mlashley/cvduino/README.md

# CVduino

Documenting my attempt to make a general purpose MIDI/CV/Arduino-like board.
