mlashley/cvduino/hardware/pwm_cv_multisim_weblink.txt

https://www.multisim.com/content/9pv5kF2uwTvokZKrmRoAAM/pwm-to-cv/open/
