mlashley/cvduino/misc/links.txt

https://web.archive.org/web/20190512002632/https://www.stereoping.com/eurorack-diy-offset-scaler/?lang=en
http://www.bartonmusicalcircuits.com/atnmix/documentation.pdf
http://www.modular.fonik.de/pdf/RetroAtt.pdf
http://www.varal.org/ttymidi/
