mlashley/cvduino/hardware/PCB.png

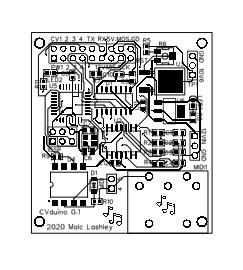
hardware/PCB.png
