mlashley/cvduino/hardware/Schematic.png

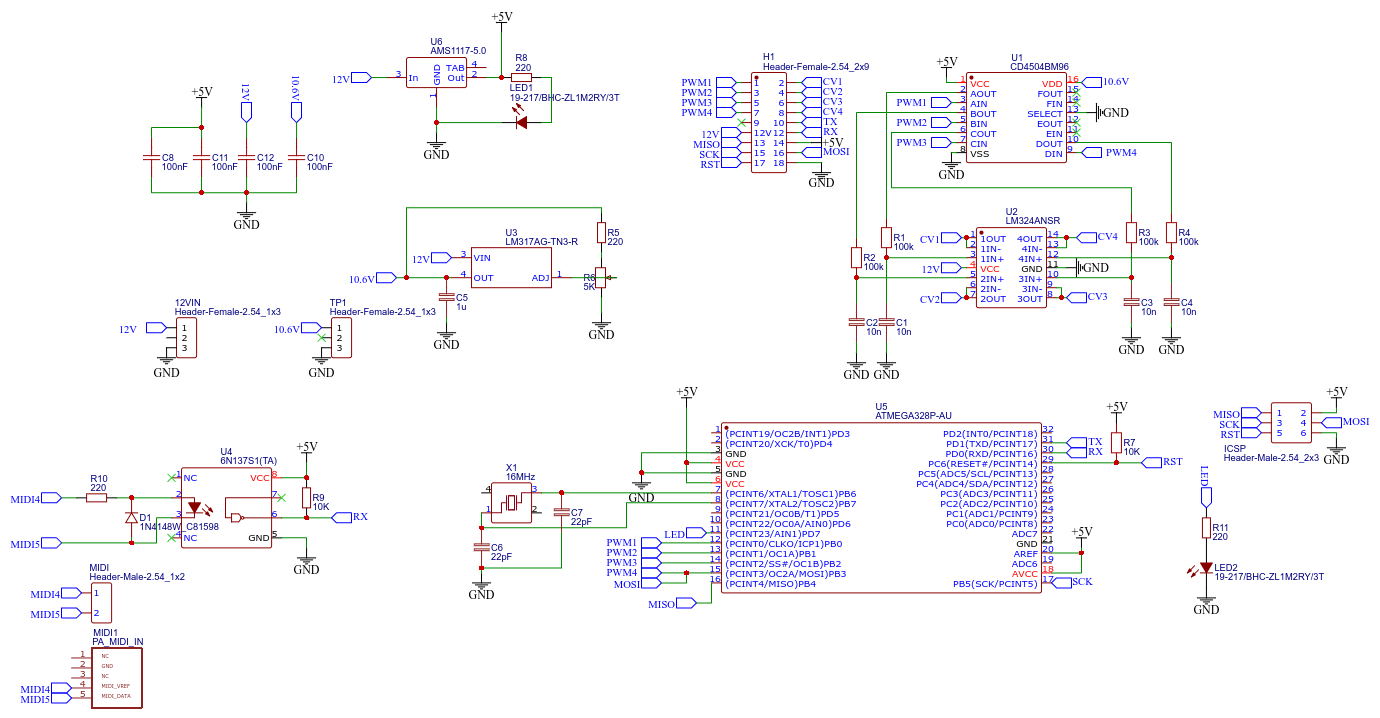
hardware/Schematic.png
