mlashley/cvduino/(list of files, drawings)

Other design files:
hardware/EasyEDA_PCB.json
hardware/EasyEDA_Schematic.json
