mlashley/cvduino/(commit log)

2020-12-24 Initial commit (HW designs as manufatured)
    [PCB_2020-11-16_02-00-22_2020-12-24_12-29-26.json]
2020-12-24 Colour PCB SVG with all layers...
2020-12-24 Add the various SPICE simulation files for picking RC in the PWM->CV path
2020-12-24 Fix SPICE PWM-Voltage
2020-12-24 File renames
    [EasyEDA_PCB.json, EasyEDA_Schematic.json]
2021-01-18 Add basic MIDI->Blink test whilst I wait for DIN-sockets to arrive...
2021-01-23 Power testing, and basic on/off testing the CV1..4 outputs
2021-01-30 Add CV calibration/test code
2021-02-21 Basic MIDI-NoteOn/Off to LED Test
2021-02-22 Fix: miditest forgot to set PWM frequency...
    [midi_test.ino]
2021-02-25 10bit PWM on Timer1
2021-02-25 Switch to FastPWM
